TinyTapeout/tt-vga-clock-pmod/tt-vga-clock-pmod.pdf

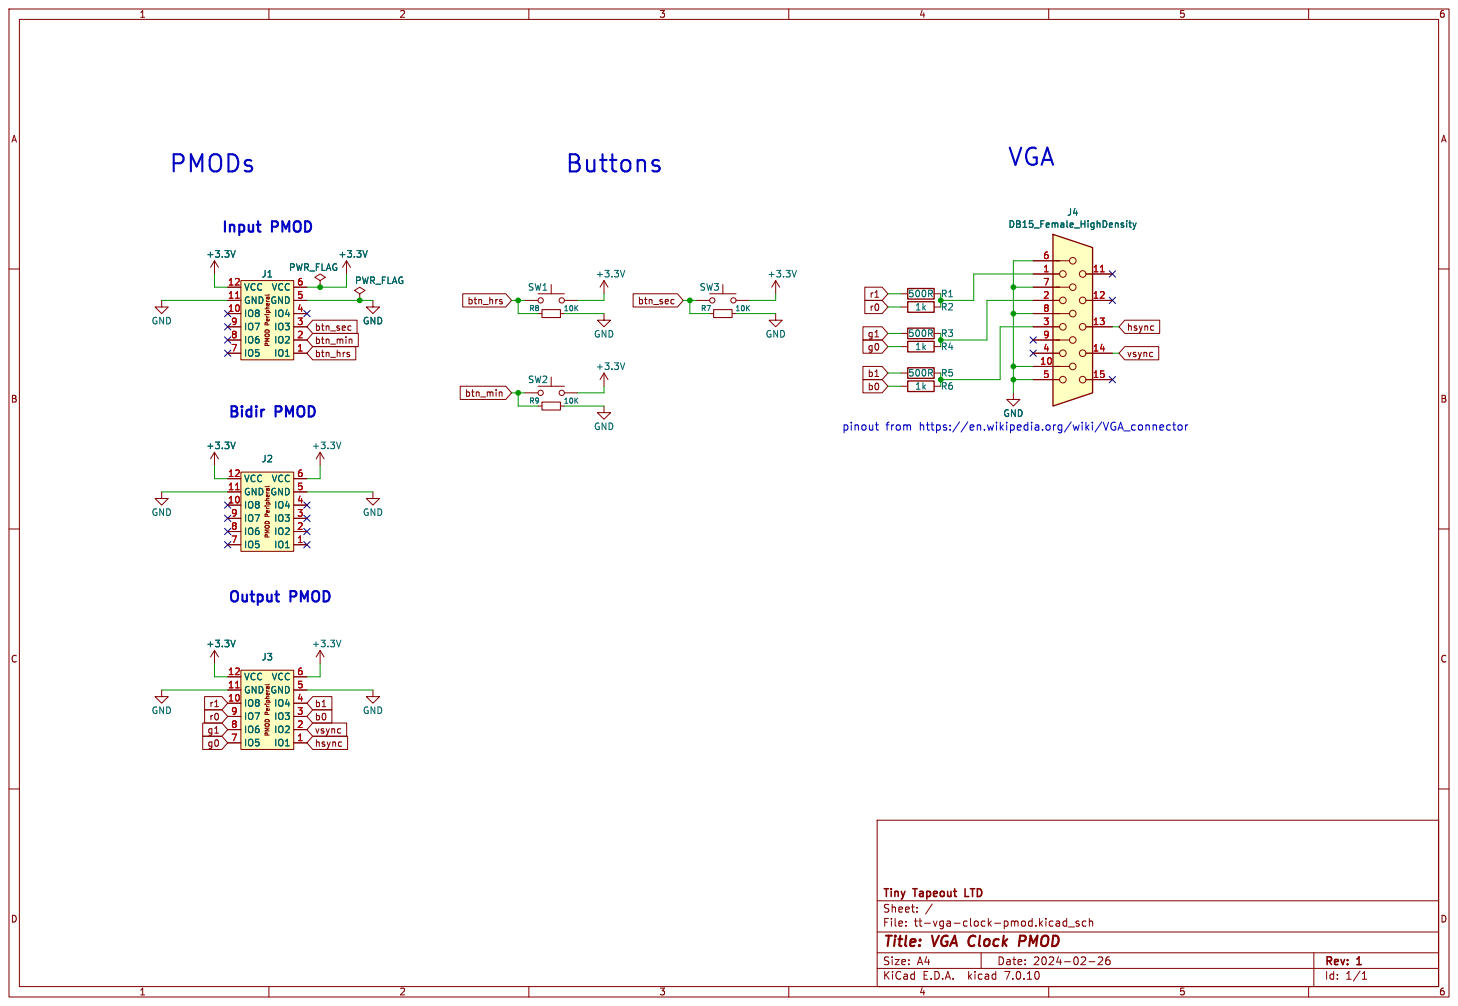
[picture p2: page 1]

pinout from https://en.wikipedia.org/wiki/VGA_connector GND

Id: 1/1 Title: VGA Clock PMOD
