TinyTapeout/tt-vga-clock-pmod/(commit log)

2024-02-26 VGA Clock PMOD
    [tt-vga-clock-pmod.kicad_pcb, tt-vga-clock-pmod.kicad_sch]
2024-02-26 docs: add schematic and 3d render
2024-02-26 pcb: increase solder_mask_to_copper_clearance
    [tt-vga-clock-pmod.kicad_pcb]
2024-02-26 pcb: update part properties from schematic
    [tt-vga-clock-pmod.kicad_pcb]
2024-02-26 pcb: add m3 mounting holes
    [tt-vga-clock-pmod.kicad_pcb]
2024-03-08 pcb: change resistor footprint to 0603
    [tt-vga-clock-pmod.kicad_pcb, tt-vga-clock-pmod.kicad_sch]
