TinyTapeout/tt-vga-clock-pmod/(notices)

Notices in the files:
tt-vga-clock-pmod.kicad_pcb:
(C) 2024 Tiny Tapeout LTD
